botheredbybees/pypilot4arion/config/README.md

# Arion live configuration snapshot

Generated by `scripts/backup_config.py` on 2026-10-09 16:30 AEDT. **Secrets are removed**: Signal K `security.json`
(only `signalk-security-summary.json` is kept), Node-RED `flows_cred.json`, `~/.pypilot/signalk-token`,
WiFi profiles (only SSID/mode summaries in `nmcli-connections.txt`), SSH keys, and anything matching
password/secret/token/psk/key patterns. Re-run the script to refresh; use `git diff config/` to see what changed.

| Folder | Node | Contents |
|---|---|---|
| `hub/` | Pi 4 `lysmarine` (192.168.20.101) | Signal K `settings.json`, plugin configs, Node-RED `flows.json`; Grafana/InfluxDB/Mosquitto config (active lines only); gpsd; NetworkManager; journald; logrotate; Arion systemd units and scripts; OpenCPN config (user `user`); package versions |
| `steering/` | Pi 3B `arionpypilot` (192.168.20.100) | `~/.pypilot/pypilot.conf` (**includes IMU calibration**), gpsd, systemd units, boot config, versions |
| `wind/` | Pi Zero `arion-wx` (192.168.20.102) | `weather.service` (rtl_433), boot config, fstab, overlayroot config |
| `grafana/` | hub:3080 | dashboards (importable JSON), datasources, folders |

Paths mirror the real filesystem (e.g. `config/hub/home/signalk/.signalk/settings.json` -> `/home/signalk/.signalk/settings.json`).

## Restoring (outline)
- **Signal K:** stop `signalk`, copy back `settings.json` / `plugin-config-data/` / `red/flows.json` (Signal K can overwrite `settings.json` while running), start it.
  `security.json` is not here: re-create devices in the admin UI (Security -> Devices; the steering pypilot device needs **Read/Write**).
- **Grafana:** Dashboards -> New -> Import -> upload the JSON; recreate the InfluxDB datasource from `datasources.json` (uid `ffgddffc2s64gc`, database `signalk`).
- **pypilot:** copy `pypilot.conf` back to `~/.pypilot/` with pypilot stopped (it holds the IMU calibration and servo limits).
- **gpsd / NetworkManager / systemd:** copy to the same path, `systemctl daemon-reload`, restart the service. WiFi passwords must be re-entered.
- The Wind Zero has a read-only root: changes need the overlay unlocked (`raspi-config`) or are lost at reboot.

See `docs/data_flows.md` for how everything fits together and why each setting is what it is.
