botheredbybees/pypilot4arion/docs/emergency_procedures.md

# Emergency Procedures & Failure Modes

**STATUS: CRITICAL** - Print this document and keep it in the chart table.

## 1. Autopilot Failure (Loss of Steering)

**Symptoms**: Boat wanders off course, rudder unresponsive when **AP** is engaged, or continuous beeping.

### Immediate Action: Manual Override
1.  **Disengage**: Tap **AP** in the web UI (`http://192.168.20.100:8000`, Control tab) so it is off (standby). There is no physical standby button on Arion. If the web UI will not load, do not wait for it: go straight to step 2.
2.  **Hydraulic Bypass**:
    *   Locate the **Bypass Valve** on the Octopus hydraulic pump.
    *   Turn the valve **Open** (Counter-Clockwise) to allow free flow of fluid.
3.  **Steer Manually**: Use the ship's wheel. The helm should feel lighter with the bypass open.

### Troubleshooting at Sea
1.  **Check Power**: Is the Steering Pi 3B (`arionpypilot`, 192.168.20.100) Green LED on?
    *   *No*: Check fuse in **Bus B (Regulated)** panel.
    *   *Yes*: Open the pypilot web UI at `http://192.168.20.100:8000`; if it will not load, power-cycle the Steering Pi (or `sudo systemctl restart pypilot pypilot_web` over SSH as `bbb`). The Hub (192.168.20.101) and wind Zero (192.168.20.102) are not part of steering.
2.  **Check Drive**:
    *   Listen for the pump motor whirring.
    *   If motor runs but rudder doesn't move: Check fluid level / Air in lines.
    *   If motor silent: Check **Bus C (High Current)** fuse for the IBT-2 controller.

## 2. Total Power Failure (Blackout)

**Symptoms**: No lights, instruments, or autopilot.

### Diagnosis
1.  **Check Voltmeter**: Read voltage at the **12V House Bank**.
    *   *Below 11V*: Battery bank is flat.
    *   *Normal (12V+)*: Main fuse/breaker has tripped.
2.  **Check Main Breaker**: Locate the 250A Main Fuse/Breaker near the Battery Bank.
    *   *Tripped?*: Reset ONCE. If it trips immediately, **STOP**. You have a dead short.
    *   *Intact?*: Check main isolation switch.

### Emergency Lighting
*   Use standalone battery torches.
*   The **Engine Start System (Bus C)** is isolated and should still function to start the engine, providing alternator power.

## 3. Engine Start Failure

If the 12V Start Battery is dead:

### Jump Start Procedure (12V House Bank)
1.  **Confirm**: 12V House Bank has charge (check voltmeter — above 12V).
2.  **Disconnect House Loads**: Turn off Fridge, Autopilot, Inverter to maximize available current.
3.  **Bridge Banks**: If a VSR/combiner is fitted, engage it manually. Otherwise, temporarily connect House Bank (+) to Start Battery (+) with jump leads.
4.  **Wait**: Allow 2-3 minutes for the Start Battery to surface charge.
5.  **Crank**: Attempt to start engine.
6.  **Remove Bridge**: Once engine is running, disconnect jump leads (if used).

## 4. Fire / Smoke

1.  **ISOLATE BATTERIES**: Turn OFF the **Main Battery Switches** (House & Start) immediately.
    *   *Location*: Under companionway steps / Nav station.
2.  **Extinguish**: Use ABC Fire Extinguisher. Do **NOT** use water on electrical fires.
3.  **Assess**: Do not restore power until the melted wire/component is identified and disconnected.
