botheredbybees/pypilot4arion/docs/wind_sensor_integration.md

# Wind Sensor Integration Guide

## Overview

This guide documents the integration of the **Ecowit WS80** ultrasonic anemometer into the *Arion* navigation system. Unlike traditional wired marine wind sensors, the WS80 is wireless (433MHz), solar-powered, and ultra-low maintenance (no moving parts).

> **Node-RED (verified 2026-10-07):** the conversion is done by a Node-RED flow hosted inside Signal K (`signalk-node-red` plugin, flows in `/home/signalk/.signalk/red/flows.json` on the hub, **flow "WS80 Raw Data"**). It reads `rtl_433/arion-wx/events`, converts `wind_dir_deg` to radians and `battery_mV` to volts, and sends Signal K deltas as source `node-red-ws80` (`environment.wind.angleApparent`, `electrical.batteries.ws80.voltage`). No separate Node-RED service exists, and the `signalk-rtl433` plugin described further down is **not** what is in use.
>
> **Current setup (verified 2026-10-07):** The RTL-SDR runs on the **wind bridge** `arion-wx` (Pi Zero WX, 192.168.20.102), not the hub. It runs `rtl_433 -F mqtt://192.168.20.101 1883 retain 1 events rtl_433/arion-wx/events`, publishing to Mosquitto on the hub (Pi 4, 192.168.20.101), which feeds Signal K. The wind Zero uses **overlayroot (read-only root)**: changes, logs and SSH keys vanish on reboot (password SSH only, no local logs). Do not unlock it unless you mean to. Reboot history is in `/var/log/arion/zero-mqtt-events.log` on the hub. Sections below that install or run rtl_433 on the Pi 4 are the earlier design and should not be repeated on the hub or the Zero.

We use a Software Defined Radio (RTL-SDR) to receive the sensor's data, decode it, and inject it into the Signal K server. Pypilot then consumes this data to enable **Wind Mode** steering.

## Hardware Stack

1.  **Sensor**: Ecowit WS80 6-in-1 Ultrasonic Sensor (Solar powered, 4.8s update rate).
2.  **Receiver**: Generic RTL-SDR V3/V4 USB Dongle with 433MHz antenna.
3.  **Computer**: Raspberry Pi 4 (Lysmarine).

## Software Stack

1. **rtl_433**: Command-line tool to decode 433MHz signals and publish to MQTT.
2. **Mosquitto**: The local MQTT broker acting as the data bus on Arion.
3. **Signal K**: The central hub using the `MQTT Gateway` and `MQTT Sensors` plugins.
4. **Node-RED**: Handles unit conversions (e.g., Battery mV to Volts) for precise display.
5. **Pypilot**: Consumes Signal K wind data for steering.

## Installation & Configuration

### 1. Hardware Setup
1.  Mount the **WS80** at the masthead or a high, unobstructed location. Align the "North" marker correctly towards the bow.
2.  Plug the **RTL-SDR USB dongle** into a **USB 2.0 port** (black) on the Pi 4. Avoid USB 3.0 ports (blue), as they generate RF interference that can drown out the 433MHz signal.

### 2. Configure rtl_433 to MQTT
On the Pi 4, ensure `rtl_433` is broadcasting to the local Mosquitto broker. 

**Test Command:**
mosquitto_sub -t 'rtl_433/#' -v

### 3. Connect to Signal K (MQTT Bridge)
We use the **Signal K MQTT Sensors** plugin to map the raw JSON into standard marine paths.

**Plugin Configuration:**
- **MQTT Topic**: `rtl_433/arion-wx/events`
- **Mappings**:
    - `$.wind_avg_m_s` -> `environment.wind.speedApparent` (Unit: m/s)
    - `$.wind_dir_deg` -> `environment.wind.angleApparent` (Unit: deg)
    - `$.temperature_C` -> `environment.outside.temperature` (Unit: C)

### 4. Battery Monitoring (Node-RED)
The WS80 reports battery in millivolts (e.g., 3060mV). To prevent Signal K from displaying this as "3060%", use a Node-RED flow to scale the value:
- **Input**: MQTT Topic `rtl_433/arion-wx/events`
- **Logic**: `msg.payload.battery_mV * 0.001`
- **Output**: Signal K path `electrical.batteries.ws80.voltage`

## Installation & Configuration

### 1. Hardware Setup
1.  Mount the **WS80** at the masthead or a high, unobstructed location. Align the "North" marker correctly towards the bow (you can offset this in software later, but physical alignment is best).
2.  Plug the **RTL-SDR USB dongle** into the Lysmarine Pi 4.
3.  Attach the 433MHz antenna to the dongle.

### 2. Install rtl_433
On the Lysmarine Pi 4, open a terminal:

```bash
sudo apt-get update
sudo apt-get install rtl_433
```

Test reception:
```bash
# Listen for Ecowit protocol usually on 433.92MHz
rtl_433 -f 433.92M -R 156
```
*   Wait up to 16 seconds. You should see a JSON output with `wind_avg_km_h`, `wind_dir`, etc.
*   **Note the ID**: Write down the `id` field from the output (e.g., `12345`). You'll use this to filter out neighbor's sensors.

### 3. Connect to Signal K
There are two common ways to pipe data into Signal K: via **MQTT** or via the **Signal K plugin**. The Plugin method is often easier for beginners.

#### Method A: Signal K RTL_433 Plugin (Recommended)
1.  Open Signal K Admin (`http://localhost:3000`).
2.  Go to **Appstore -> Available**.
3.  Search for and install `signalk-rtl433`.
4.  Restart Server.
5.  Go to **Server -> Plugin Config -> RTL_433**.
6.  **Configuration**:
    *   **Frequency**: `433920000`
    *   **Protocols**: `156` (Ecowit)
    *   **Device ID**: Enter your sensor's ID (to ignore stray signals).
7.  Save and Enabled.

#### Method B: Command Line Pipe (Advanced)
If you prefer a robust background service:
Create a service that runs:
```bash
rtl_433 -f 433.92M -R 156 -F json | curl -X POST -H "Content-Type: application/json" -d @- http://localhost:3000/signalk/v1/api/vessels/self
```
*(Note: Method A involves less maintenance)*

### 4. Verify Data in Signal K
Go to the **Data Browser** in Signal K Admin. Look for:
*   `environment.wind.speedApparent`
*   `environment.wind.angleApparent`

If these values are updating every ~4.8 seconds, integration is successful.

## Pypilot Configuration

Now that Signal K has the wind data, Pypilot needs to see it.

1.  Ensure Pypilot is connected to Signal K (this usually happens automatically via mDNS/Discovery on the same network).
2.  In **OpenCPN**, enable the Pypilot dashboard.
3.  You should now see the "Wind" button become active (no longer greyed out).
4.  **Wind Mode**:
    *   Click **WIND**.
    *   Pypilot will now steer to maintain a constant Apparent Wind Angle (AWA).

## Troubleshooting

*   **No Signal**:
    *   Check antenna connection.
    *   Verify you are using the correct frequency (433MHz vs 915MHz - depends on region/model). US/Aus models are often 915MHz, EU is 433MHz. Check your WS80 sticker!
    *   If 915MHz, change `rtl_433` command to `-f 915M`.
*   **Wrong Direction**:
    *   If the wind angle is consistently off (e.g., shows 180° when head-to-wind), adjust the Offset in Signal K (Server -> Data -> Derived Data -> Offset not usually available directly, use a "Calibration" plugin in Signal K).

---
**Related Documentation**:
*   [Lysmarine Integration](lysmarine_integration.md) - The host system for RTL-SDR.
*   [System Overview](../README.md)
