botheredbybees/pypilot4arion/config/hub/nmcli-connections.txt

NAME                 TYPE      DEVICE      AUTOCONNECT  AUTOCONNECT-PRIORITY  ACTIVE 
YachtArion           wifi      wlan0       yes          10                    yes    
tailscale0           tun       tailscale0  no           0                     yes    
lo                   loopback  lo          no           0                     yes    
<other-wifi>                 wifi      --          yes          0                     no     
lysmarine-hotspot    wifi      --          no           0                     no     
lysmarine-hotspot 1  wifi      --          no           0                     no     
Wired connection 1   ethernet  --          yes          -999                  no     

== YachtArion
connection.autoconnect:                 yes
connection.autoconnect-priority:        10
connection.autoconnect-retries:         0 (forever)
802-11-wireless.ssid:                   YachtArion
802-11-wireless.mode:                   infrastructure
802-11-wireless.band:                   --
ipv4.method:                            manual
== <other-wifi>
connection.autoconnect:                 yes
connection.autoconnect-priority:        0
connection.autoconnect-retries:         -1 (default)
802-11-wireless.ssid:                   <other-wifi>
802-11-wireless.mode:                   infrastructure
802-11-wireless.band:                   --
ipv4.method:                            auto
== lysmarine-hotspot
connection.autoconnect:                 no
connection.autoconnect-priority:        0
connection.autoconnect-retries:         -1 (default)
802-11-wireless.ssid:                   lysmarine-hotspot
802-11-wireless.mode:                   ap
802-11-wireless.band:                   bg
ipv4.method:                            shared
== lysmarine-hotspot 1
connection.autoconnect:                 no
connection.autoconnect-priority:        0
connection.autoconnect-retries:         -1 (default)
802-11-wireless.ssid:                   lysmarine-hotspot
802-11-wireless.mode:                   infrastructure
802-11-wireless.band:                   --
ipv4.method:                            auto
