botheredbybees/pypilot4arion/docs/archive/README.md

# Archived docs

Kept for history only. They describe designs Arion no longer uses and **must not be followed** for the current boat.
Current architecture and verified settings: [../data_flows.md](../data_flows.md).

| File | What it described | Why archived |
|---|---|---|
| `tinypilot_setup.md` | Pi Zero ("TinyPilot") as the pilot computer, on the `192.168.43.x` hotspot | Replaced by the Pi 3B steering node at 192.168.20.100 |
| `openplotter_setup.md` | OpenPlotter-based setup (pasted chat transcript) | Hub runs Lysmarine; steering runs Debian + pypilot |
| `pilothouse_nav_panel_plan.md` | Panel layout with Pi Zero LCD, Pixel 2 hotspot, 24 V-era items | Superseded design |
| `wireless_hotspot.md` | Phone/Pixel hotspot network and `192.168.43.x` addressing | Boat network is now the EZR23 router (YachtArion, 192.168.20.x) |

Move a file back to `docs/` and update its banner if it becomes current again.
