botheredbybees/pypilot4arion/docs/img/PXL_20260118_002617187.jpg

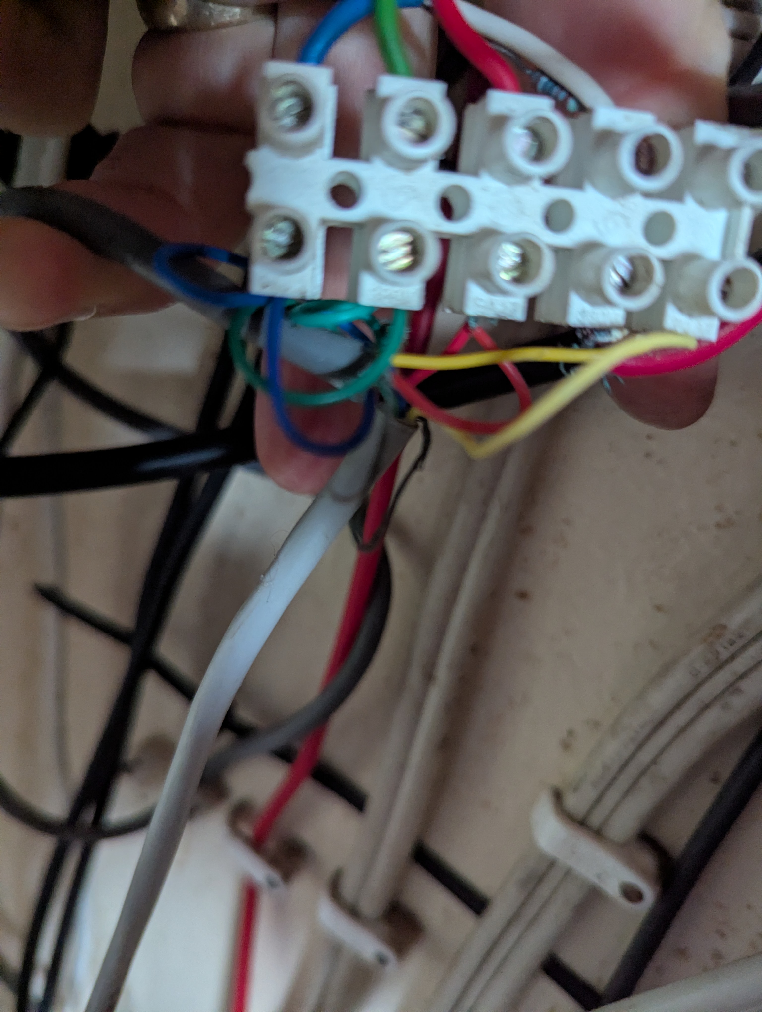
docs/img/PXL_20260118_002617187.jpg
