botheredbybees/pypilot4arion/docs/img/PXL_20260118_002617330.jpg

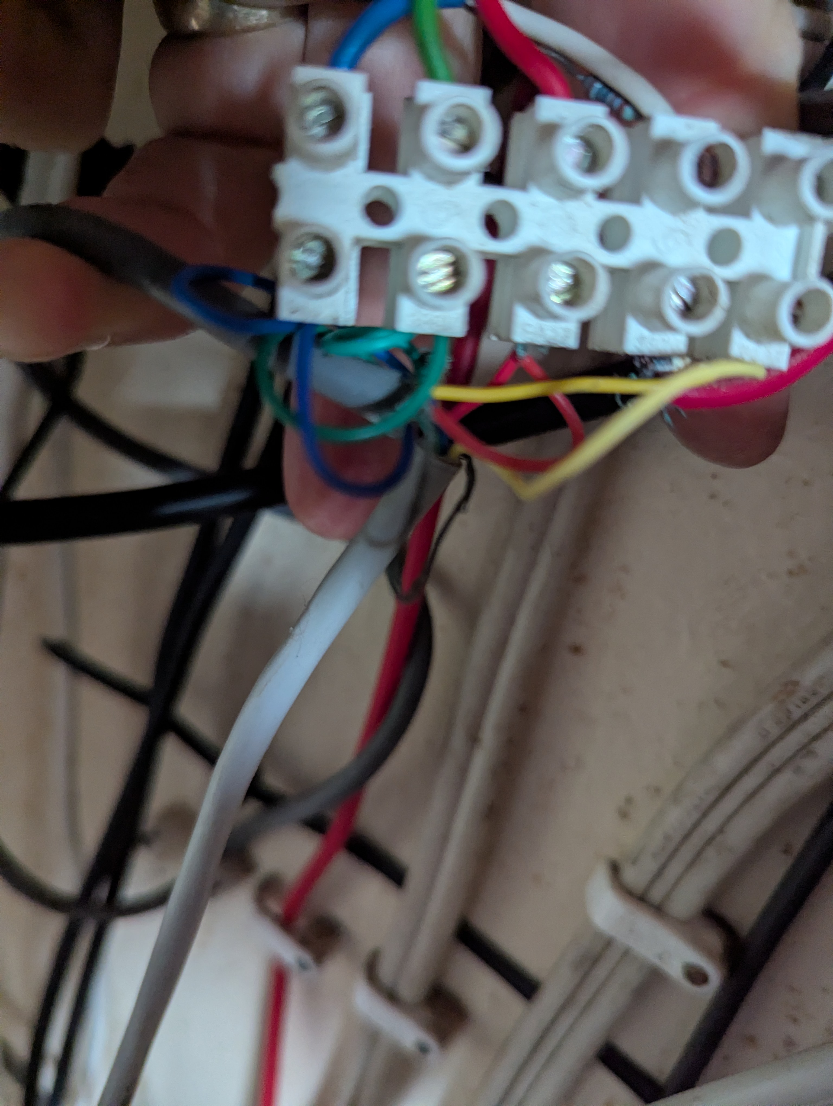
docs/img/PXL_20260118_002617330.jpg
