botheredbybees/pypilot4arion/docs/img/PXL_20260118_004804481.jpg

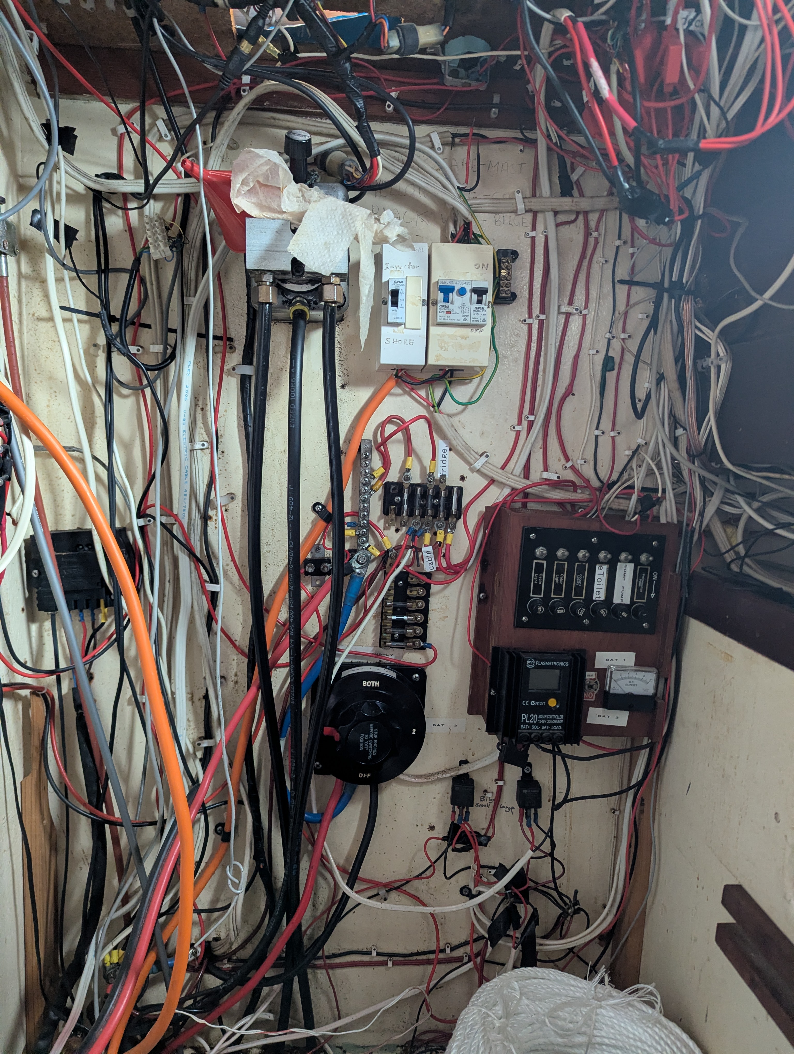
docs/img/PXL_20260118_004804481.jpg
