botheredbybees/pypilot4arion/docs/img/PXL_20260119_005715037.jpg

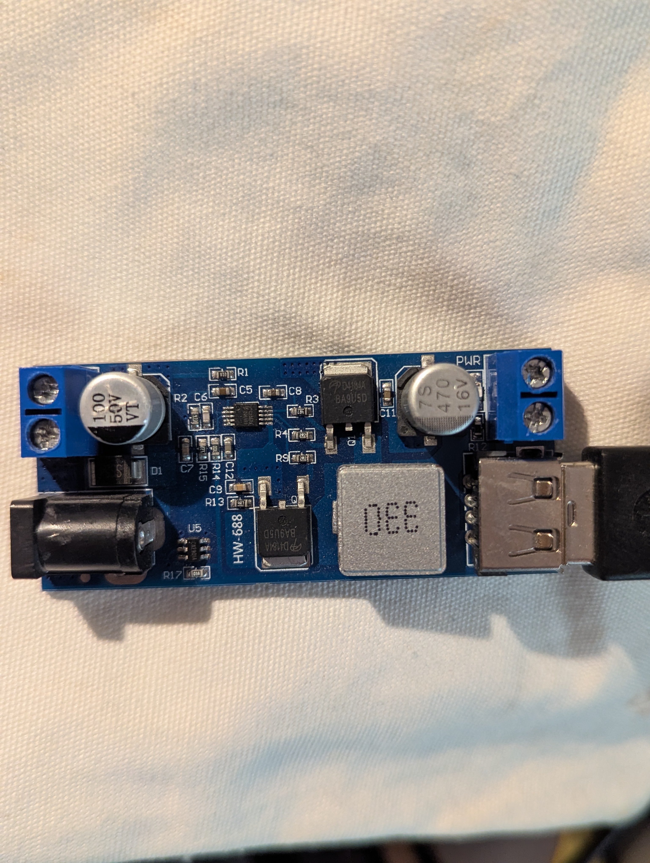
docs/img/PXL_20260119_005715037.jpg
