botheredbybees/pypilot4arion/docs/img/PXL_20260119_005728616.MP.jpg

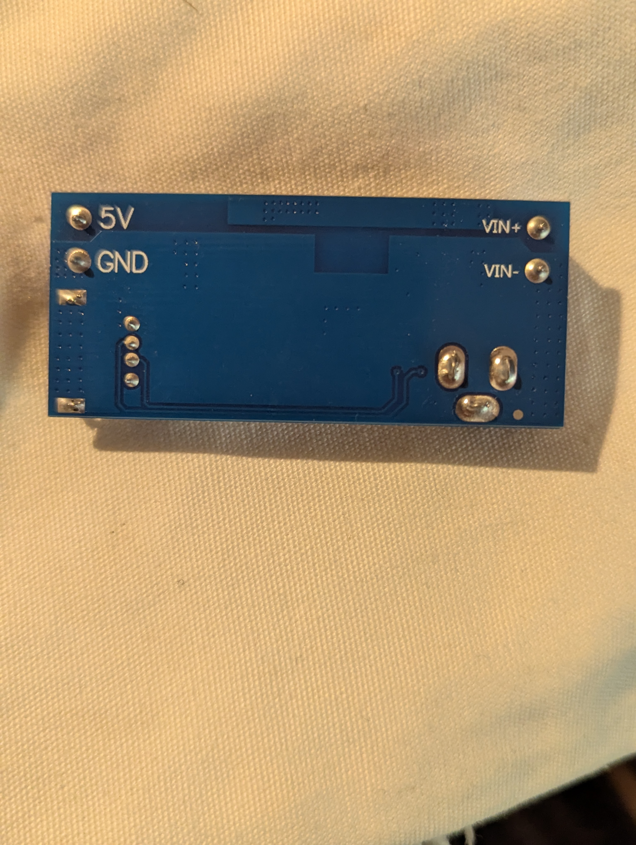
docs/img/PXL_20260119_005728616.MP.jpg
