botheredbybees/pypilot4arion/docs/img/PXL_20260119_034908050.jpg

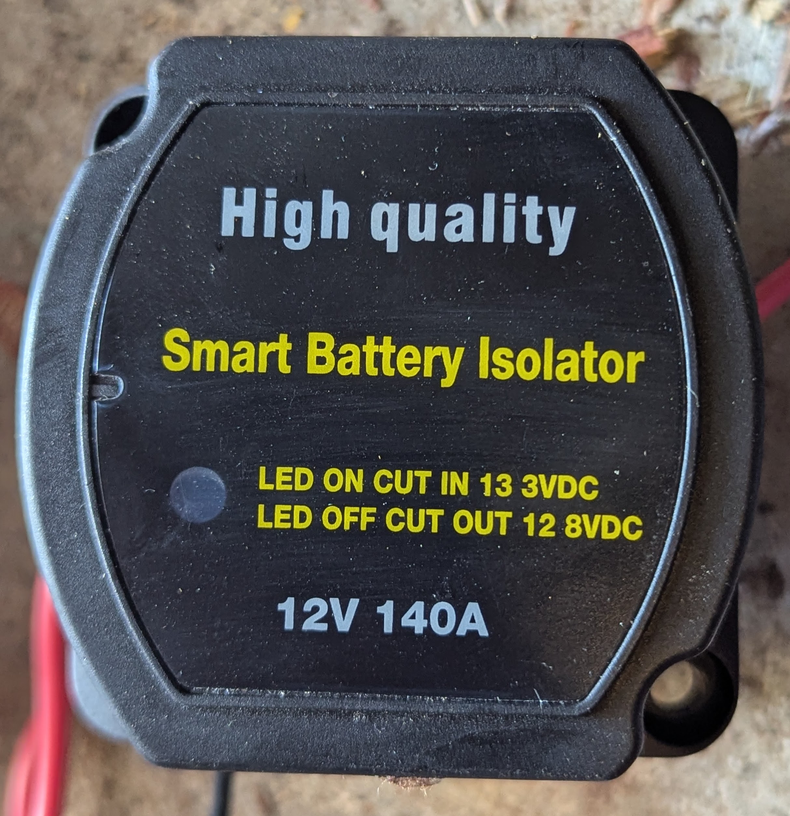
docs/img/PXL_20260119_034908050.jpg
