botheredbybees/pypilot4arion/docs/img/PXL_20260119_054052084.jpg

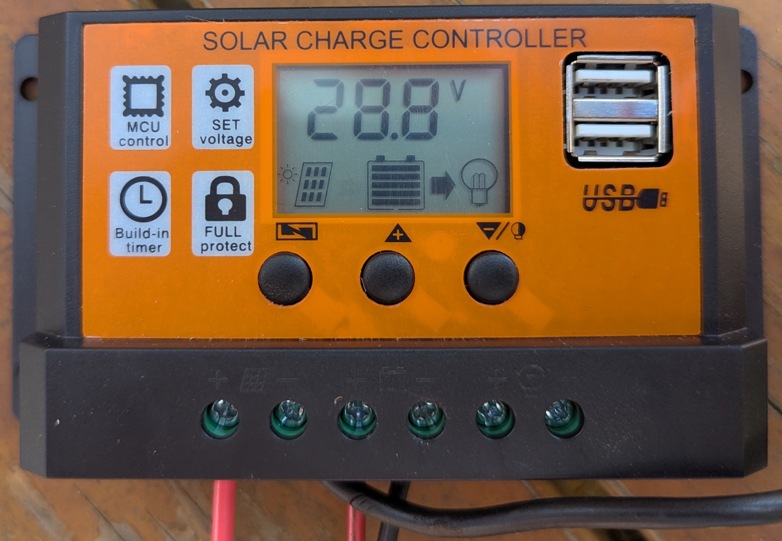
docs/img/PXL_20260119_054052084.jpg
