botheredbybees/pypilot4arion/docs/img/PXL_20260119_235127785.jpg

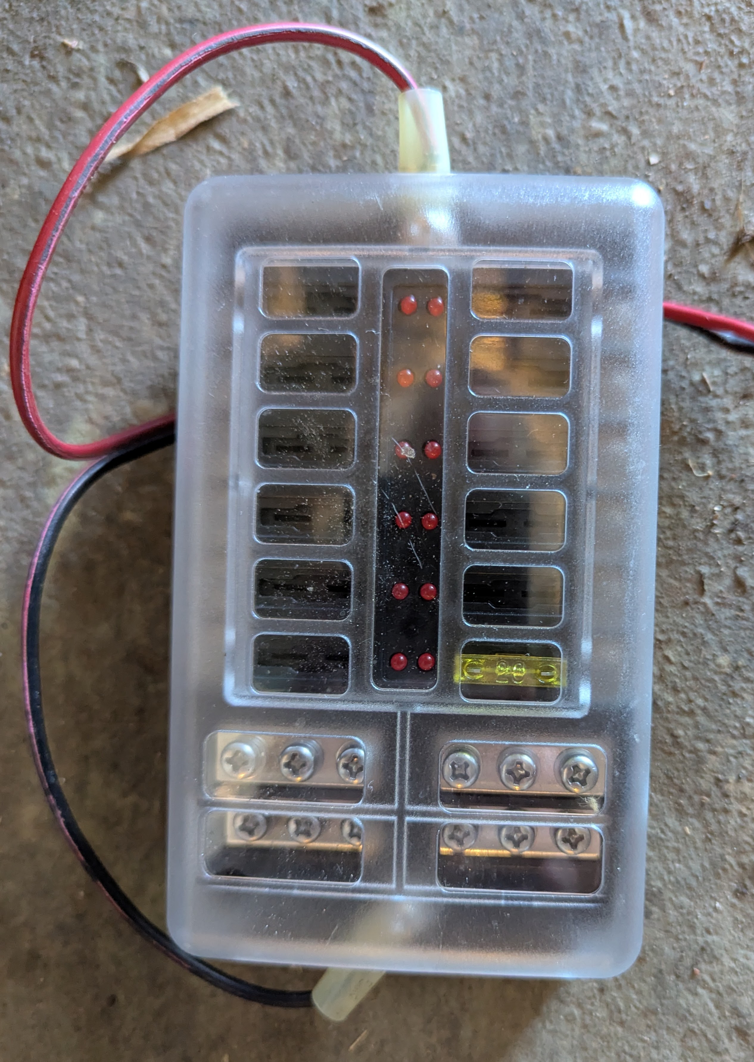
docs/img/PXL_20260119_235127785.jpg
