botheredbybees/pypilot4arion/docs/img/PXL_20260119_235203468.jpg

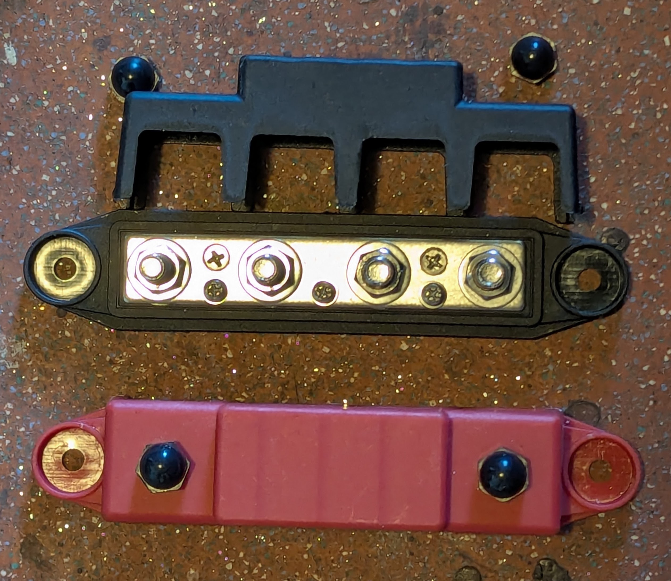
docs/img/PXL_20260119_235203468.jpg
