botheredbybees/pypilot4arion/docs/img/PXL_20260119_235247853.jpg

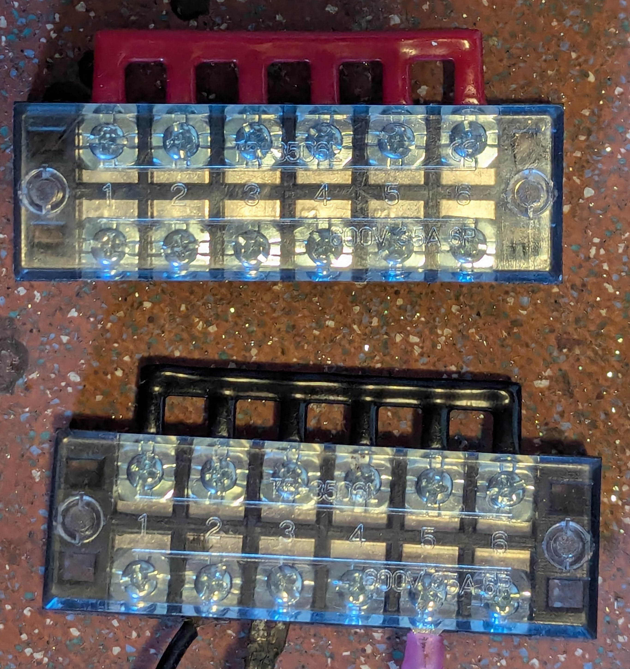
docs/img/PXL_20260119_235247853.jpg
