botheredbybees/pypilot4arion/docs/img/PXL_20260119_235300463.jpg

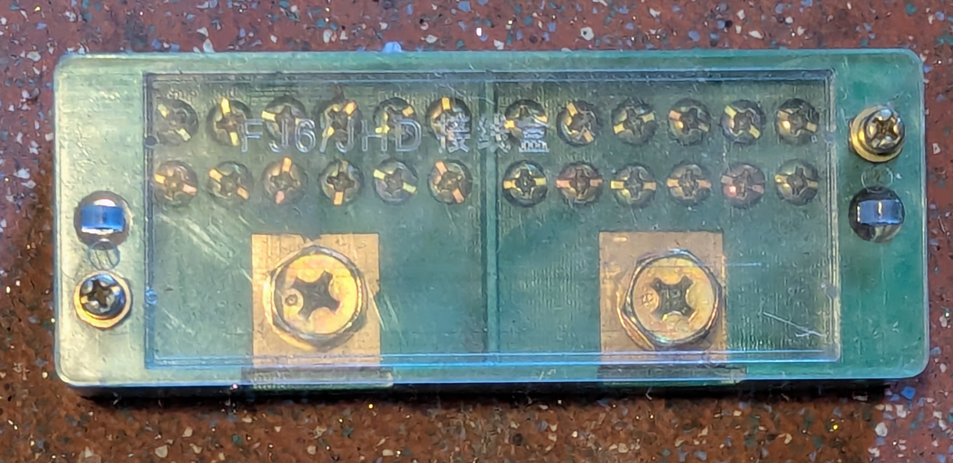
docs/img/PXL_20260119_235300463.jpg
