botheredbybees/pypilot4arion/docs/img/PXL_20260119_235356558.jpg

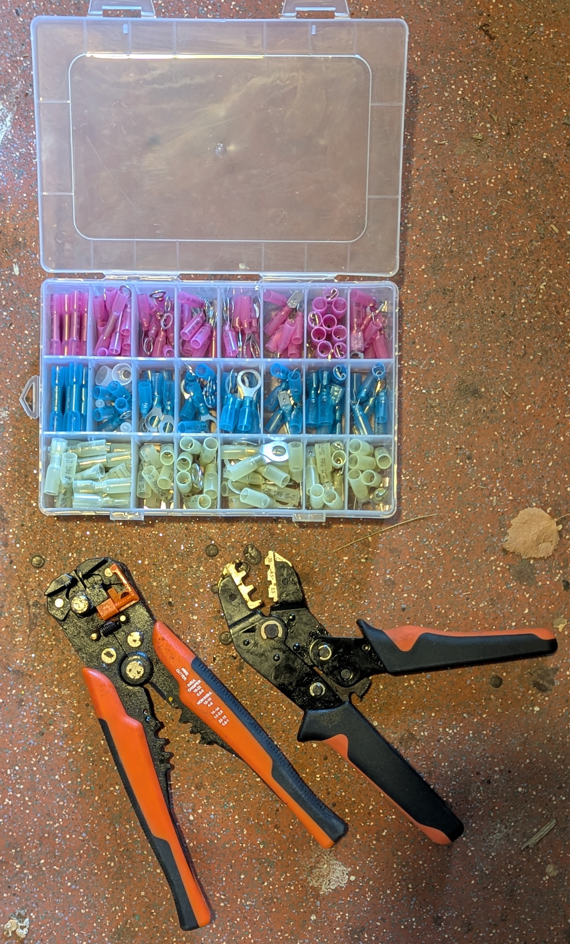
docs/img/PXL_20260119_235356558.jpg
