botheredbybees/pypilot4arion/docs/img/PXL_20260119_235426759.jpg

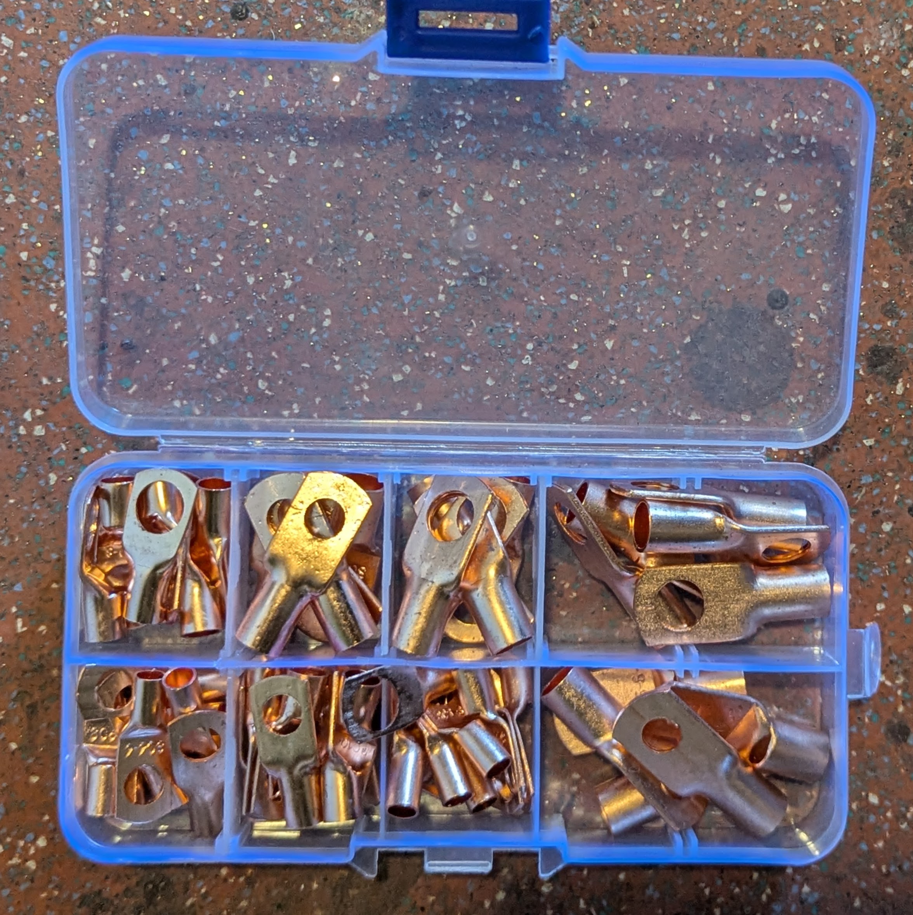
docs/img/PXL_20260119_235426759.jpg
