botheredbybees/pypilot4arion/docs/img/PXL_20260119_235431921.jpg

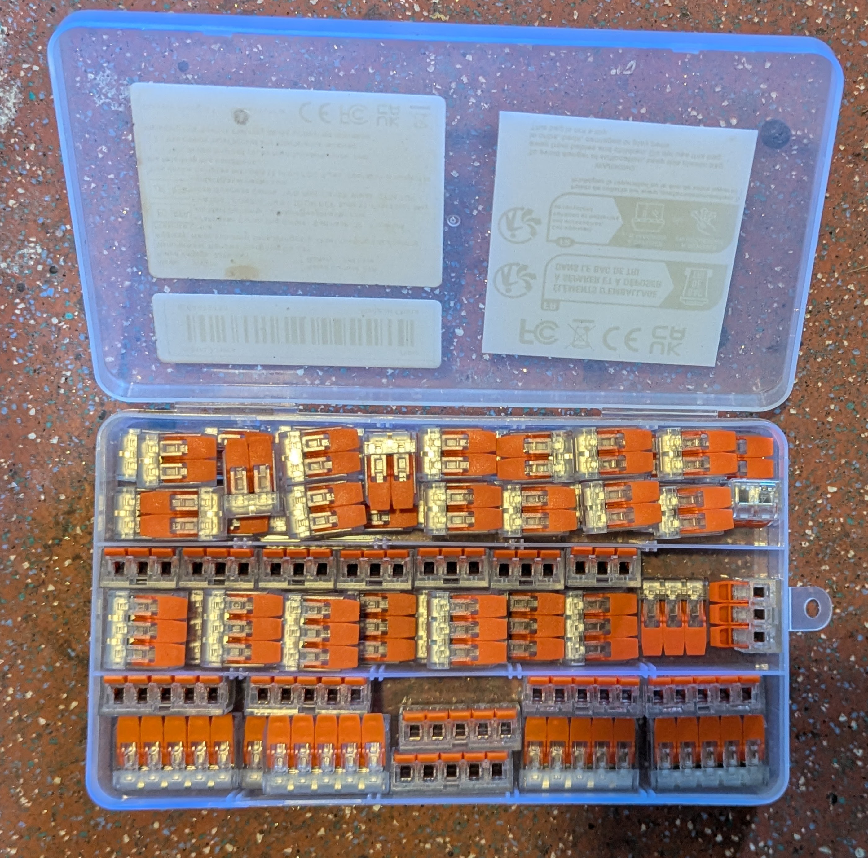
docs/img/PXL_20260119_235431921.jpg
