botheredbybees/pypilot4arion/docs/img/PXL_20260121_003005637.jpg

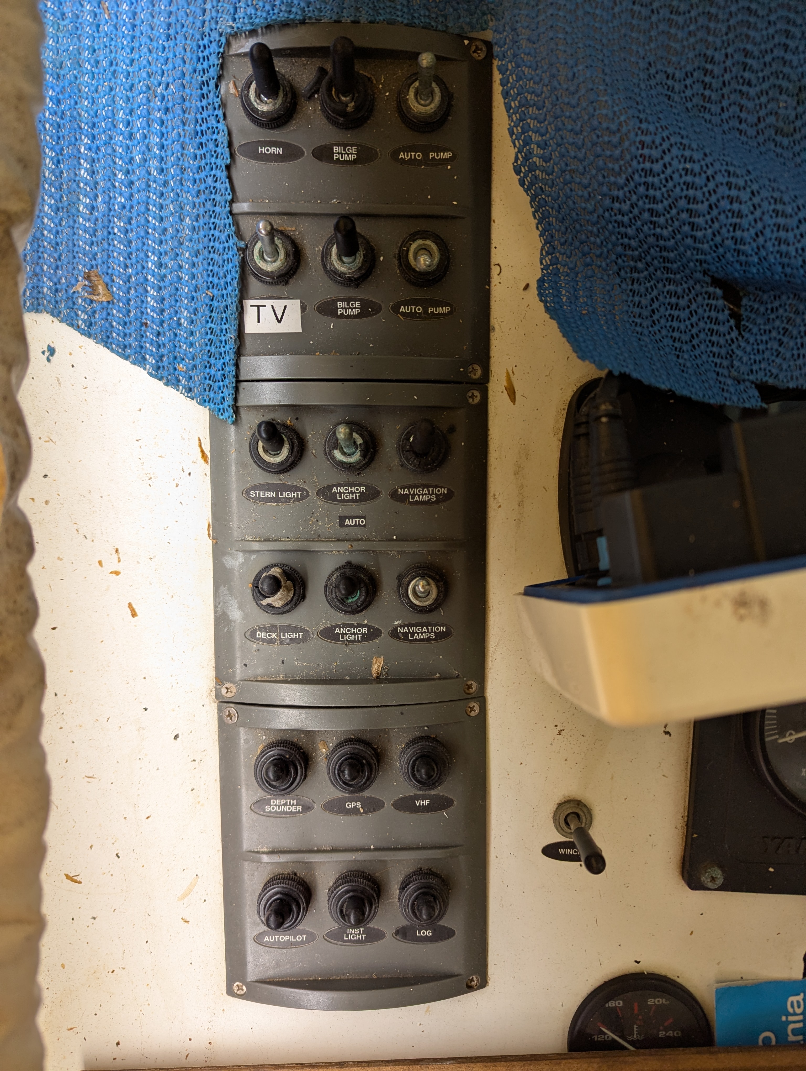
docs/img/PXL_20260121_003005637.jpg
