botheredbybees/pypilot4arion/docs/img/PXL_20260121_003030984.jpg

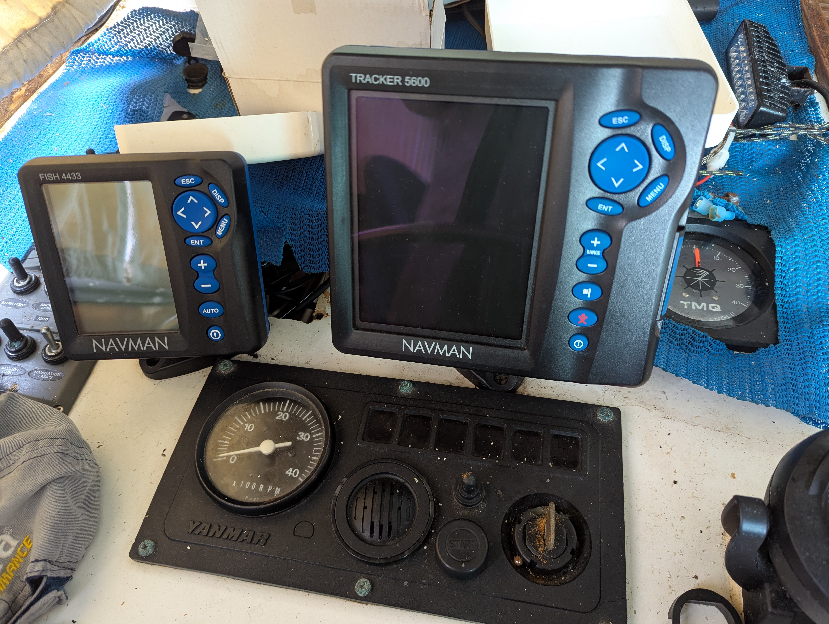
docs/img/PXL_20260121_003030984.jpg
