botheredbybees/pypilot4arion/docs/img/PXL_20260121_003049784.jpg

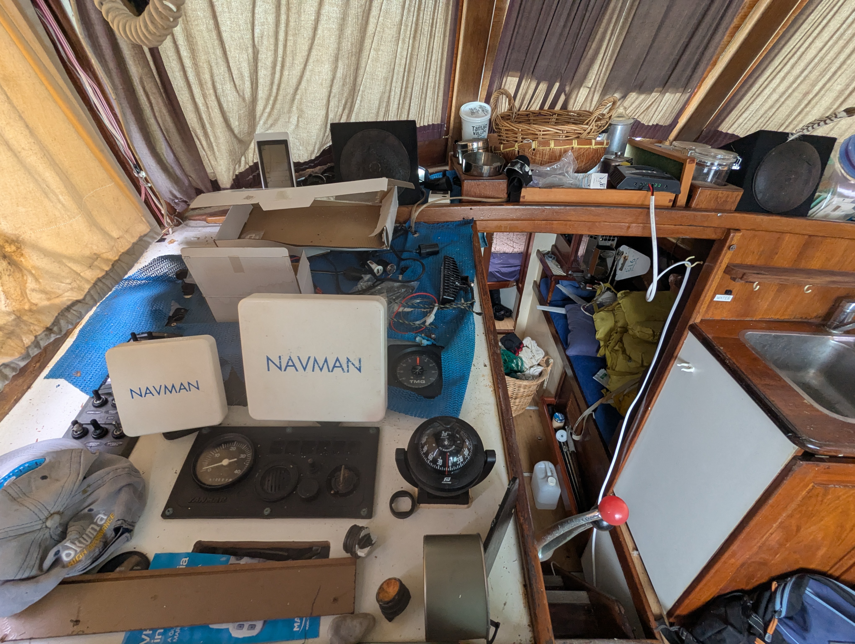
docs/img/PXL_20260121_003049784.jpg
