botheredbybees/pypilot4arion/docs/img/PXL_20260121_003110920.MP.jpg

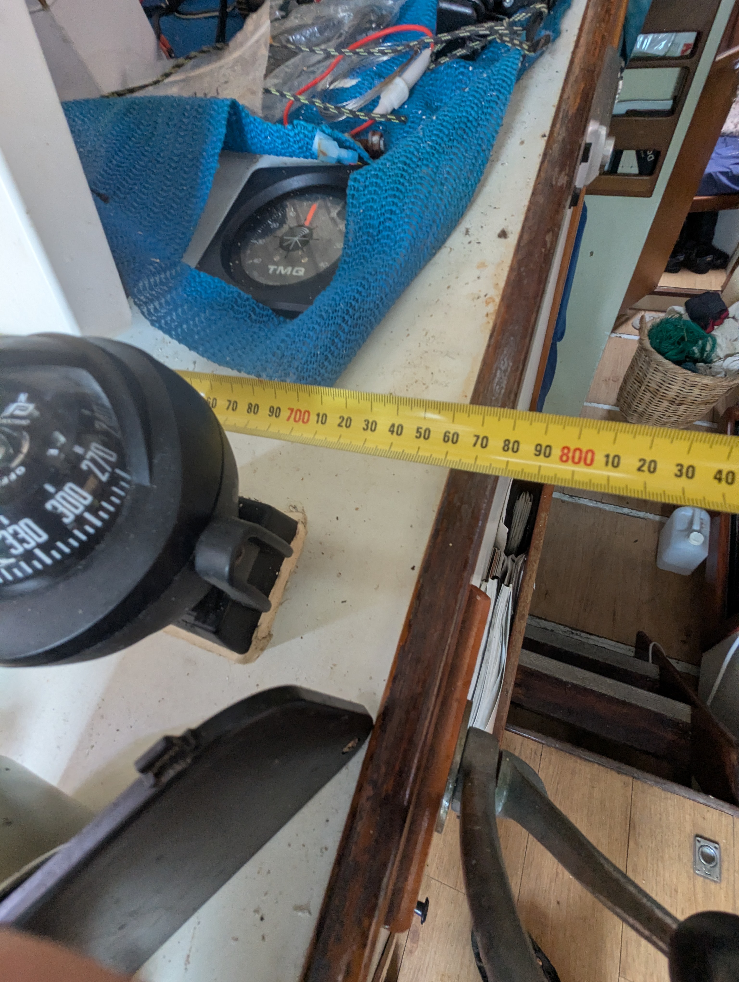
docs/img/PXL_20260121_003110920.MP.jpg
