botheredbybees/pypilot4arion/docs/img/PXL_20260121_003134509.jpg

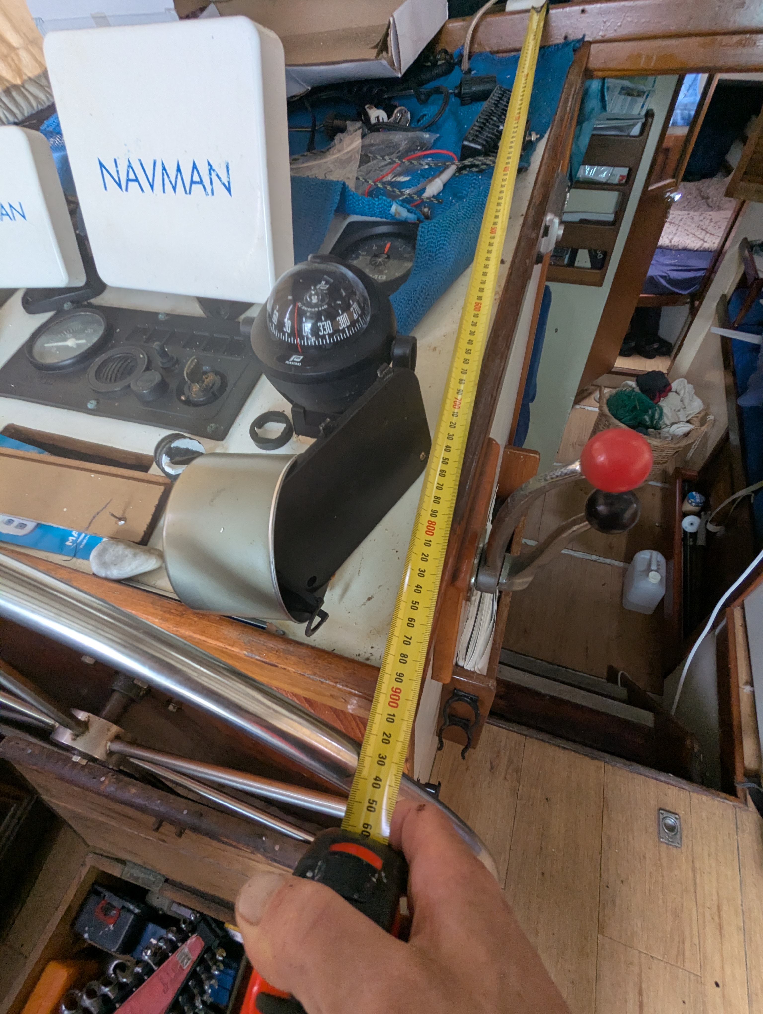
docs/img/PXL_20260121_003134509.jpg
