botheredbybees/pypilot4arion/docs/img/PXL_20260121_003158513.jpg

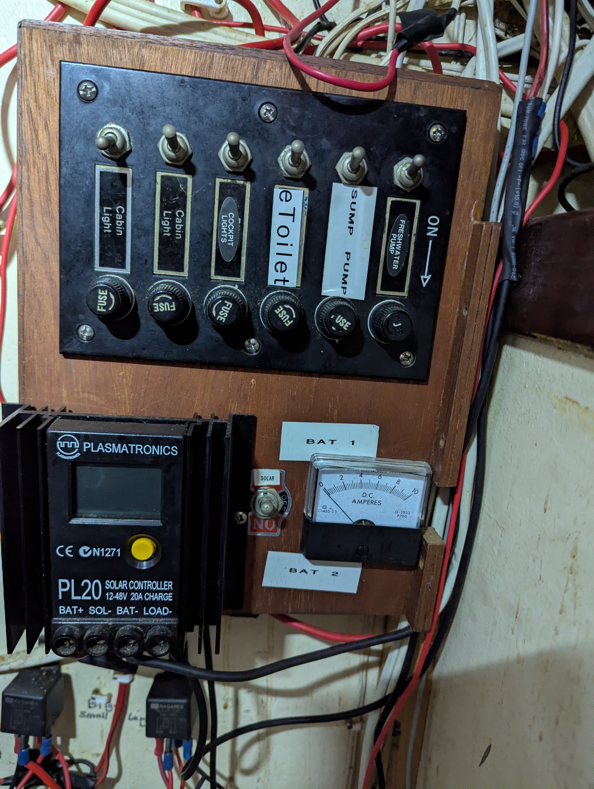
docs/img/PXL_20260121_003158513.jpg
