botheredbybees/pypilot4arion/docs/img/PXL_20260121_003204256.jpg

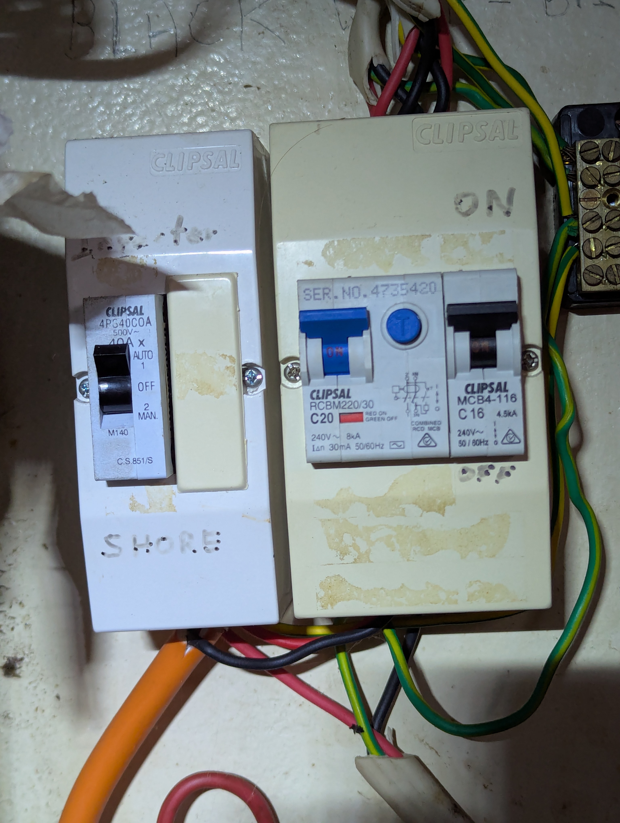
docs/img/PXL_20260121_003204256.jpg
