botheredbybees/pypilot4arion/docs/img/PXL_20260121_003209145.jpg

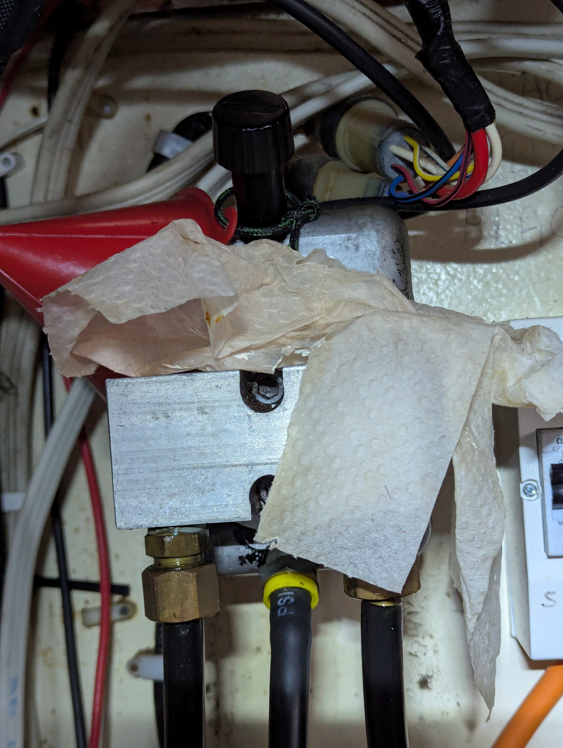
docs/img/PXL_20260121_003209145.jpg
