botheredbybees/pypilot4arion/docs/img/PXL_20260121_003214954.jpg

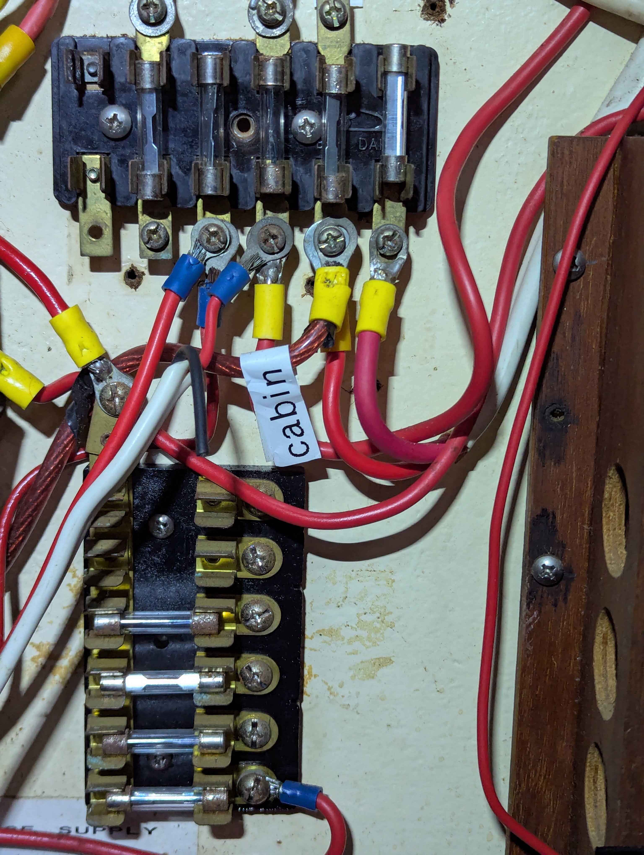
docs/img/PXL_20260121_003214954.jpg
