botheredbybees/pypilot4arion/docs/img/PXL_20260121_003217375.jpg

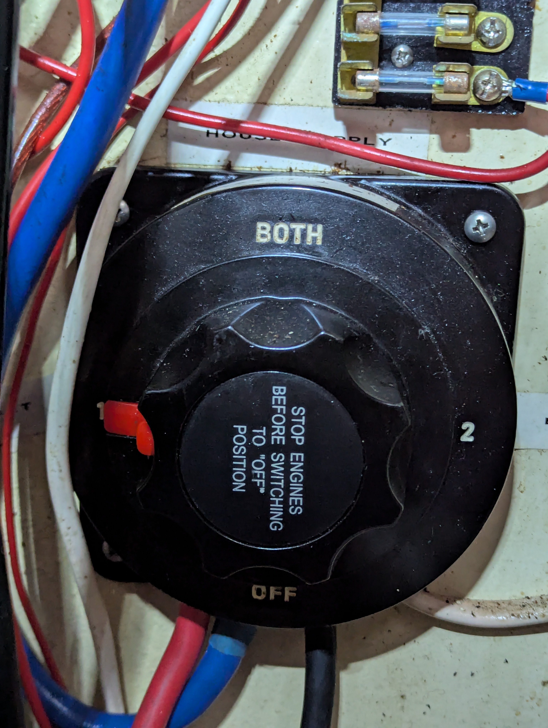
docs/img/PXL_20260121_003217375.jpg
