botheredbybees/pypilot4arion/docs/img/PXL_20260121_003221498.jpg

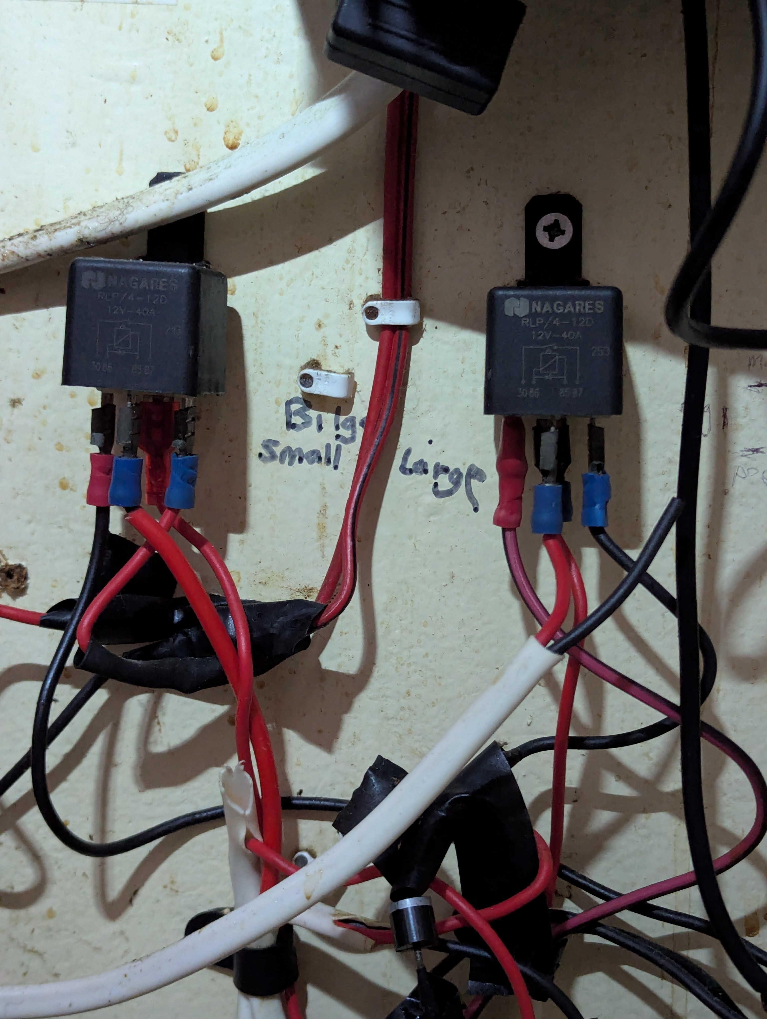
docs/img/PXL_20260121_003221498.jpg
