botheredbybees/pypilot4arion/docs/img/PXL_20260121_003227057.jpg

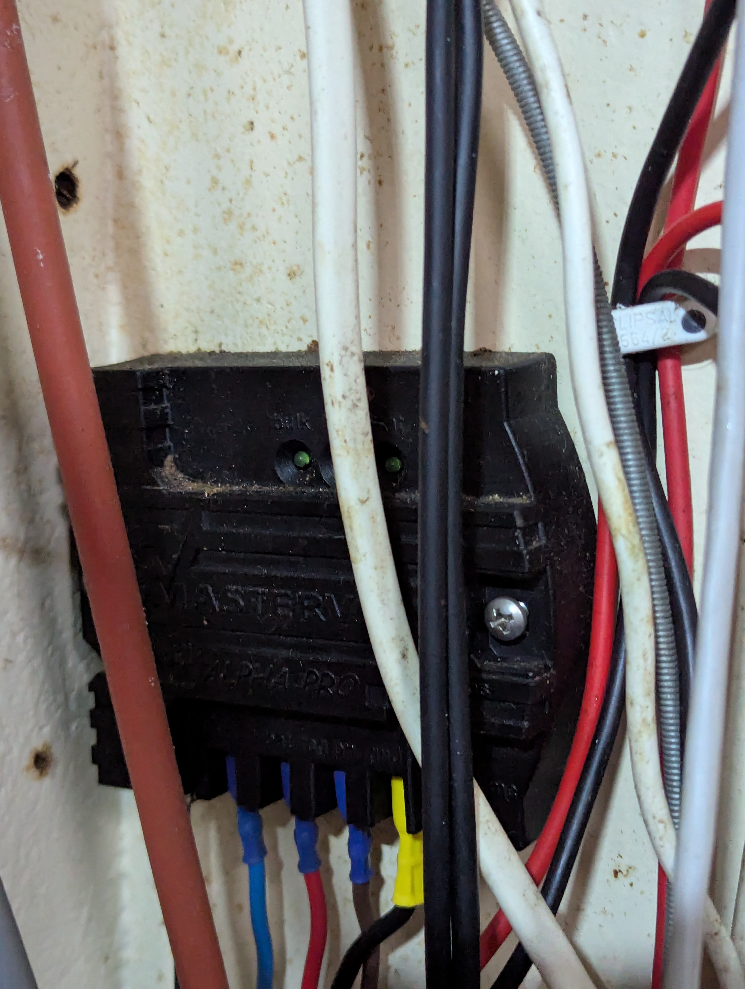
docs/img/PXL_20260121_003227057.jpg
