botheredbybees/pypilot4arion/docs/img/PXL_20260121_003256504.jpg

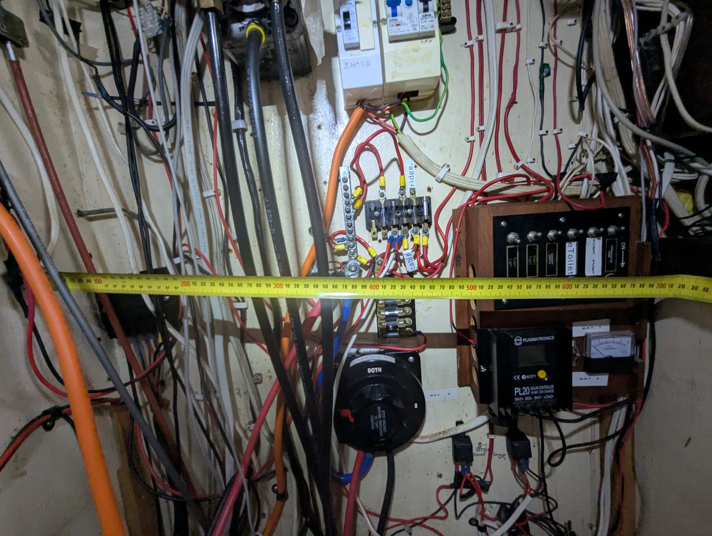
docs/img/PXL_20260121_003256504.jpg
