botheredbybees/pypilot4arion/docs/img/PXL_20260121_003334533.jpg

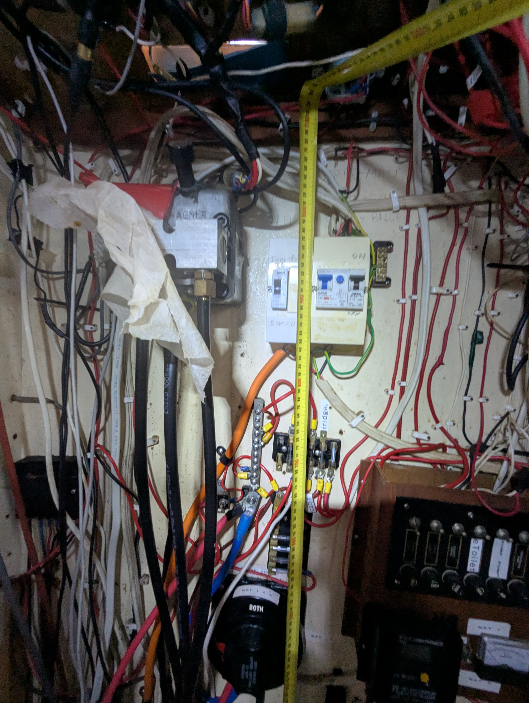
docs/img/PXL_20260121_003334533.jpg
