botheredbybees/pypilot4arion/docs/img/PXL_20260121_003540878.jpg

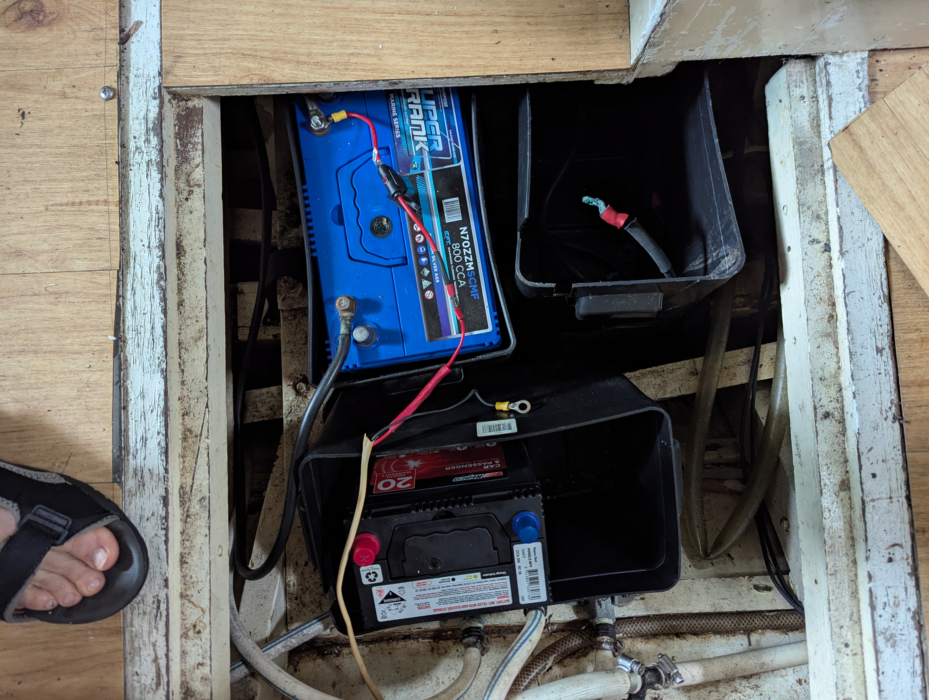
docs/img/PXL_20260121_003540878.jpg
