botheredbybees/pypilot4arion/docs/img/PXL_20260121_003604448.jpg

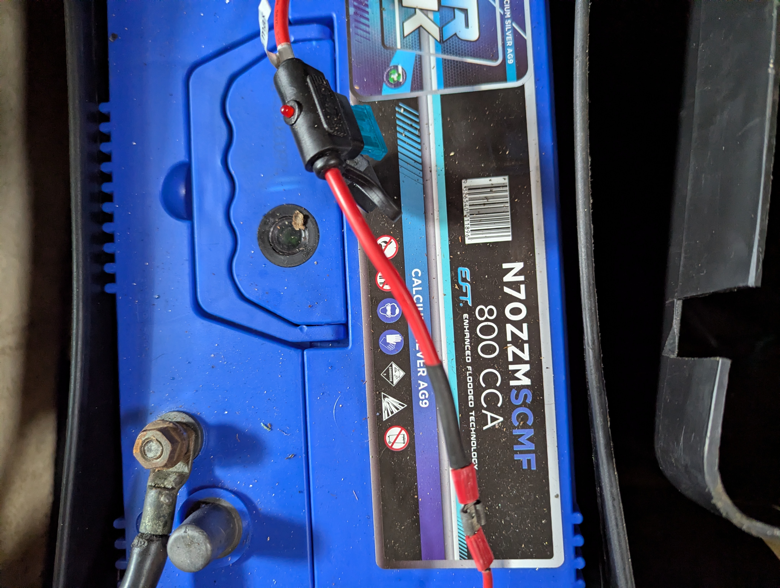
docs/img/PXL_20260121_003604448.jpg
