botheredbybees/pypilot4arion/docs/img/PXL_20260121_003608419.jpg

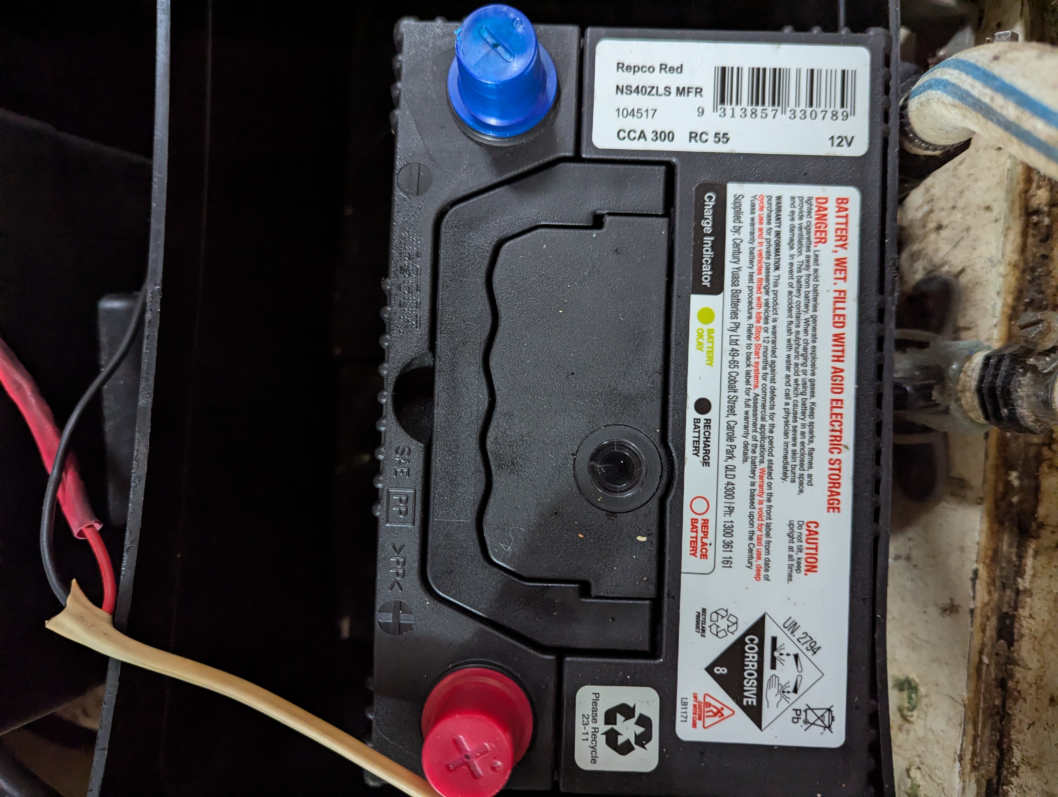
docs/img/PXL_20260121_003608419.jpg
