botheredbybees/pypilot4arion/docs/img/PXL_20260121_003649709.jpg

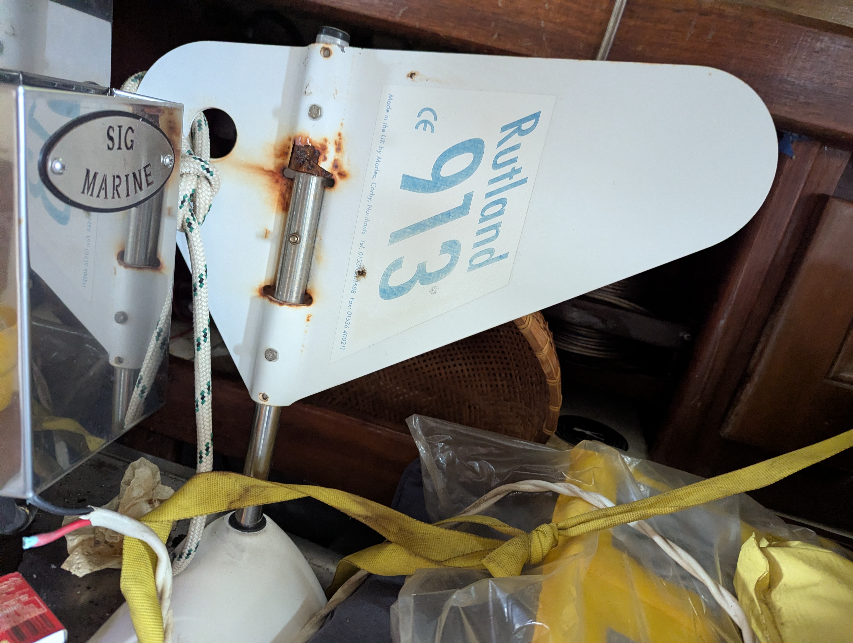
docs/img/PXL_20260121_003649709.jpg
