botheredbybees/pypilot4arion/(commit log)

2026-01-15 initial commit from clone and doc downloads
    [babel.cfg]
2026-01-18 Update README: Remove solenoids, add direct IBT-2 motor control, Pixel 2 hotspot, and future Ecowit WS80 wind sensor with rtl_433 integration
2026-01-18 Update README: Correct solenoid description, add local USB GPS to Pi Zero for standalone operation, convert all prices to AUD
2026-01-18 Correct terminology: Replace 'solenoid valves' with '12V automotive relays', add relay H-bridge circuit diagram and advantages of solid-state replacement
2026-01-19 Add wireless hotspot setup documentation
2026-01-19 Add link to wireless hotspot documentation
2026-01-19 Add DC-DC buck converter power supply details
2026-01-19 Add comprehensive 24V solar charging system documentation with installation guide and BOM
2026-01-19 updated 24v solar documentation
2026-01-20 added wind sensor, rewiring, maintenance and operations documentation
2026-01-20 updated readme to include arduino instructions
2026-01-20 added a testing and tuning guide for the tinypilot and arduino
2026-01-20 documented Rudder Feedback & TMQ Gauge Integration
2026-01-20 discussing using the 'load' terminals on the solar controller rather than the fuse block
2026-01-21 planning for 12v system rather than 24v for comparison
2026-01-26 Update TinyPilot setup for standard Raspberry Pi OS, 12V power, EZR23 router, static IP, and custom wiring without HAT
2026-01-27 replaced wiringpi package with more modern python3-gpiozero
2026-01-27 added instructions for tinypilot button controls
2026-01-27 updated button contol docs
2026-02-07 changed to usng MNugget6750 motor.ino for better BT_2 motor controller compatability
2026-04-14 getting environmental data (inside temp, pressure and air quality)
2026-04-15 removed old references to 24v system (an earlier, but now abandoned, idea)
2026-04-15 added documentation about wiring for brownout protection
2026-04-15 updated docs for bilge pump connection before battery isolator, put anchor light on mppt load terminals to protect battery overnight
2026-10-07 Add data-flow reference and correct node architecture
    New docs/data_flows.md records the verified GPS/Signal K/gpsd/OpenCPN/
    Node-RED flows, access, backups and rollback. README and CLAUDE.md now
    list all three nodes (wind bridge at .102), both GPS pucks, the locked
    Zero, the disabled hub pypilot and do-not-regress rules.
    Claude-Session: https://claude.ai/code/session_01NmnmawySMYv8xnHBKoPfdZ
2026-10-07 Correct legacy and inaccurate docs to match the live system
    Fix IPs/roles (.100 steering, .101 hub, .102 wind), replace TinyPilot and
    192.168.43.x references, rewrite cockpit/emergency controls for the web
    UI (AP toggle, mode drop-down), fix the WS80 topic and Node-RED notes,
    add 5V undervoltage notes. Safety procedures and electrical values
    unchanged; unverifiable items left for owner confirmation.
    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
2026-10-07 Document apt key fix, package upgrades, WS80, nav mode and Grafana access
    - Grafana 13.2.3 and InfluxDB 1.13.1 upgraded with backups; Grafana is on :3080
    - Grafana anonymous Viewer enabled
    - WS80 angle reference confirmed (faces bow); voltage stable 3.00-3.08 V since April
    - pypilot nav mode needs an OpenCPN Output to 192.168.20.100:20220 (APB); steps recorded
    - Wind Zero outages logged as an open issue
    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
2026-10-07 Document persistent journal, logrotate fix and WiFi power-save setting
    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
2026-10-07 Record verified pypilot nav mode via OpenCPN APB output
    With an OpenCPN Output connection to 192.168.20.100:20220 and an active
    route, pypilot lists nav and apb.source = tcp. Engaging in nav mode is
    not yet tested; notes on the unread-socket overflow and serial probes.
    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
2026-10-07 Document native pypilot link, wind angle range fix and SOG findings
    - steering pypilot device set to read/write in Signal K; restart so it reconnects
    - Node-RED wraps WS80 angle to -pi..pi (fixes bogus Grafana mean near 0/360)
    - pypilot echoes wind back into Signal K; priorities have no visible effect
    - SOG jitter at rest is a puck-placement issue, uncorrelated with apparent wind
    - Grafana Autopilot State panel needs Fields = All fields
    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
2026-10-09 Add sanitized config snapshot and backup script
    config/ holds redacted copies of the Signal K, Grafana, gpsd, pypilot (incl. IMU
    calibration), NetworkManager and systemd configuration from the hub, steering
    node and wind Zero, plus Grafana dashboards. scripts/backup_config.py refreshes
    it and aborts if any .env secret, token or key leaks. security.json,
    flows_cred.json, signalk-token, WiFi credentials, SSH keys and OpenCPN position
    lines are deliberately excluded.
    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
    [config.txt]
2026-10-09 Document BoatInstrument state/TWS flows and ms priority timeouts; refresh config snapshot
    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
2026-10-10 Add shore Wi-Fi link plan (Bullet M2 HP ashore, Wavlink WN570HA1 aboard)
    Planned, not started: Bullet as a shore AP, Wavlink as a client feeding
    the EZR23 WAN port, 4G as backup. Records that the EZR23 "PoE & LAN"
    port is PoE input only and that the Wavlink is 24 V passive PoE.
    Claude-Session: https://claude.ai/code/session_013zTGkKUUsEiTvU7MXLEkJ5
2026-10-11 Document hub WiFi failures, recovery timer and Bullet/Wavlink shore link
    - data_flows.md: router refusing hub WiFi association, recovery timer,
    two-account note, power-up troubleshooting, open issues.
    - network_map.md: shore link plan, Bullet M2 settings, airMAX must be off
    (first icon-only tab), firmware 6.3.26, verified Wavlink join.
    - scripts/hub: wifi-recovery script, service and timer (installed on hub).
    Claude-Session: https://claude.ai/code/session_01XYjCaAYWZL9fCnMcVRRkQa
2026-10-11 Document shore link results: EZR23 uplinks, mwan3 failover, 4G test
    - network_map.md: uplink table (wan 10 / wwan 20 / MOBILE 30), mwan3 timings,
    how to tell which route is live, failover/fail-back/4G tests, flow client
    disabled, radio moved to channel 11, Wavlink Wi-Fi must stay on.
    - data_flows.md: hub WiFi failures likely tied to the single-radio flow client.
    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
2026-10-11 To-do: use spare Linksys SD208 as boat switch, make Ethernet optional pending soak test
    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
